yifanlu/psvsd/(threads)

Thread 1 (2017-05-31):

why dont you run the POR circuit from the 3.3V supply? :P

urjaman, 2017-05-31:
Save a resistor, and it'll actually do the reset off when the 3.3V goes up...

(Not a big issue, but github doesnt have that good messaging... feel free to close.)

yifanlu, 2017-05-31:
So the specs require that you hold reset low for 1us _after_ device powerup (which is 400us). Now if I have the LDO output directly to resetn, then there is no guarantee of the 1us hold. The RC circuit is there to ensure that this is the case. Quick calculation shows that since Vita's Vdd is a 4V output, we need a 165k/100k voltage divider to get ~2.5V output (which is a little above V_IH). The 0.1uF capacitor will make the ramp-up time ~30ms, which is good enough for the required 1us hold. Hope that makes sense.

urjaman, 2017-05-31:
I meant you could run R3 from VDD33 instead of VDD5 and remove R2.
This would give ... 10ms RC time with the current values, which again would be just fine.

yifanlu, 2017-05-31:
I see what you mean, but as long as it's not a problem, I don't think it's worth changing the circuit. The resistor is plenty cheap, so cost isn't an issue. And it's worth saving some current draw.

Closed 2017-05-31.

Thread 2 (2017-06-13):

Improve design with Microchip's feedback

yifanlu, 2017-06-13:
Microchip provided some good feedback on the design. However, in the interest of time and costs, I think the current design is "good enough" for the first run of cards. I think they will work 99.9% of the time in 99.9% of use cases. Incorporating these comments will only make it better.
[Lu Elec USB2244 USBCheck Review Results 6-13-2017.pdf](https://github.com/yifanlu/psvsd/files/1073111/Lu.Elec.USB2244.USBCheck.Review.Results.6-13-2017.pdf)
[Full Contact Via.pdf](https://github.com/yifanlu/psvsd/files/1073110/Full.Contact.Via.pdf)
[MLFApplicationNotes0908RevG[1].pdf](https://github.com/yifanlu/psvsd/files/1073113/MLFApplicationNotes0908RevG.1.pdf)
[USB 2.0 Routing Guidelines v1.0.pdf](https://github.com/yifanlu/psvsd/files/1073112/USB.2.0.Routing.Guidelines.v1.0.pdf)

The following will be done:

- [x] Select crystal with drive level between 300uW and 500uW with 350ppm accuracy
- [x] Recalculate C3 & C4, the crystal capacitors
- [x] Verify C7,C8 are low ESR
- [x] Improve POR circuit

yifanlu, 2017-06-22:
New crystal has 6pF load capacitance. This makes C3/C4 good enough.

Closed 2017-06-22.

Thread 3 (2017-09-10):

Ordering the Board on PCBWay

Gnarmagon, 2017-09-10:
I am new to ordering PCB's or even assembling them. I want to upgrade my PSVita with the Psvsd Board but sadly it's sold out on Indiegogo :(
I asked you already on Twitter where I can order the Board assembled and you told me to look on PCBWay but sadly I have no clue what to fill in or how to produce the Board. Can you give me a Screennshot of what you filled in ? / share the Project via Link if possible ? ([example](https://www.pcbway.com/project/shareproject/SD2VITA___Gadorach.html))

yifanlu, 2017-09-10:
1. Download both files from https://github.com/yifanlu/psvsd/releases/tag/v2.1.1
2. Go here https://www.pcbway.com/pcb-assembly.html "Quantity" (I recommend > 100 or it'll be REALLY expensive per unit) "Number of Unique Parts" = 11 "Number of SMT Parts" = 11 "Number of Thru-Holes Parts" = 0. Click calculate.
3. Now change "Assembly Side(s)" to Double sides. Click "PCB Specifications".
4. Change Quantity to the same quantity specified earlier. "Size (single)" = 30x33.2mm "Thickness" = 1.0 and leave other options as is.
5. Press calculate and add to cart. You will be asked to upload gerbers for the PCB (pass psvsd-v21-1.zip as is) and to upload the BOM (extract psvsd-v21-1-assembly.zip and pass in the xlsx).
6. Wait a day for them to send you the proper quote. Make sure to tell them to ensure that the GL823 part is the 3.3V version! This is important, they almost messed up the first time.

It will cost ~$1400 for 500 pieces. ~$700 for 100 pieces. ~$100 for 10 pieces and so on so it's cheaper to buy more at once.

Gnarmagon, 2017-09-11:
thanks for the Answer but for a normal Person it's way too expensive (the assemblie) :(

Closed 2017-09-11.

Thread 4 (2017-09-18):

Ordering small run.

DieKatzchen, 2017-09-18:
If I'm ordering boards for myself, do you think hasl is good enough or do I need to spring for the enig? Also, does the pad on u1 need to be connected or can I cheat by soldering around the edges? Or is it one of the qfn chips that don't have accessible edges?

yifanlu, 2017-09-18:
1) HASL is good enough
2) It's QFN (no edges)
3) Make sure you get the 3.3V version (the 5V version is called GL823B but is also labeled GL823 on the chip)

DieKatzchen, 2017-09-18:
Gotcha. Ended up buying it on aliexpress in the end, but this is all useful info to have. It should probably be mentioned somewhere that the board should be 1mm thick. Found that info on my own.

Closed 2017-09-18.

Thread 8 (2018-04-05):

psvemmc: resolve issues found by Microchip USBcheck

yifanlu, 2018-04-05:
[USB2244 USBCheck Review Results 4-5-2018.pdf](https://github.com/yifanlu/psvsd/files/1880809/USB2244.USBCheck.Review.Results.4-5-2018.pdf)
[Schematic Checklist USB2244 QFN Rev A.pdf](https://github.com/yifanlu/psvsd/files/1880810/Schematic.Checklist.USB2244.QFN.Rev.A.pdf)

Thread 9 (2018-08-16):

PSVSD 2.1 discharging the battery in TURN OFF mode

sin89rus, 2018-08-16:
first i have psvsd (copy from ALI) v 2.1
i grounded shield like in v 2.1.1
when Vita is turned OFF (not sleeping) mode, its slowly discharging the battery - 1% in 2hrs
if i etract PSVSD module, The battery is not discharged even by one percent for the whole day

nobody have this problem?
i think copy made by official manual, and If this problem is present here, then it is in the original

yifanlu, 2018-08-16:
1% in 2 hours is not typical but also not unusual. It’s worse if your battery is old and has a lower capacity.

sin89rus, 2018-08-16:
New tests result:
 separate from each other - PSVSD and Vita Memory Card working fine without battery discharge
 But when together it's happened - minus 10% for a night.
Are you know the solution? You can test it by your self.

yifanlu, 2018-08-16:
I've tested it before
https://drive.google.com/open?id=0B8s1lpCIQGWCTnJzMjA1aGhndTQ

sin89rus, 2018-08-17:
please hear me: discharge happened ONLY if PSVSD and Vita Original MC inserted together.
If only PSVSD - discharge not happened
If only Vita MC - discharge not happened
If Both - battery start draining

Just put both inside, remember the battery % (battery shell will be useful), power off, check in 4 hours how much % battery loose.
Maybe it's happened only in Chinese copy of PSVSD, I can't check it with original one, but you can.
Maybe it's some resistance between PSVSD and Vita MC which draining battery

yifanlu, 2018-08-17:
That is weird, but there is no correlation between the two. I do not personally have any Vitas to test with but if anyone else can reproduce, I would be curious.

sin89rus, 2018-08-17:
Seems like problem gone.
I just replug battery connector (I don't unplug it before).
Looks like you need unplug battery, then insert PSVSD and plug battery connector back.

sin89rus, 2018-08-17:
Seems like problem gone.
I just replug battery connector (I don't unplug it before).
Looks like you need unplug battery, then insert PSVSD and plug battery connector back.

Closed 2018-08-16.

Thread 11 (2019-05-26):

PSVSD drains bettery even if turned off

K4thos, 2019-05-26:
My PSVSD v2.1 (official one sold by you, not the third party) discharges Vita battery even if the system is completely turned off (power button held for a few seconds and selecting turn off option). It's not much, since it takes several days to drain 10% of the battery (the percantage can be checked after installing plugin or via Adrenaline), but if you leave your system long enough, it will discharge the device to the point to not be able to even turn it on again. Apparently leaving a lithium ion battery completely dry for a month is the worst thing you can do for battery health and this will be the case if you stop using your system and leave PSVSD inside.

I've noticed similar issue reported before: https://github.com/yifanlu/psvsd/issues/9 but I didn't managed to fix it. I've tried following things to make sure that it's PSVSD v2.1 that is causing the discharge:
- leaving PS Vita turned off for about a week without PSVSD - no battery discharge whatsoever (exactly the same % of the battery)
- leaving PS Vita turned off for about week with PSVSD - several % drained,
- as above but after removing and inserting back the battery - same problem with discharge
- as above but also after removing official memory card (as was suggested in the linked issue) - same problem with discharge
- after removing PSVSD again, I’ve inserted 3G module back and the problem is no longer present (no battery discharge)

So now, after several weeks of testing, I’m reporting it here hoping for a software solution. Hopefully it’s not a unfixable PSVSD hardware flaw.

mathieulh, 2019-12-20:
I am also using the official psvsd and I have the same issue, battery drains even while the Vita is off.

dudeitssm, 2020-01-08:
I wonder...would it be possible to use a high-side load switch? That should cut down current consumption of whatever is connected on the output side to no more than a few microAmps, or even [nanoAmps](https://www.vishay.com/docs/66597/sip32431.pdf) when the PSV is off (or the EN pin does not get a HIGH signal) and thus extend the battery life to approximately whatever the self-discharge rate is for the lipo battery.

This is what I'm thinking as the flowchart:
**0**. Turn PSV on from off state.
**1**. Obtain a signal from the PSV's motherboard that is _only_ present when the PSV is on, but is _not_ on during suspend mode.
**2**. That signal is fed into the EN pin of the load switch, which activates the psvsd components. The PSV boots up and psvsd mounts sdcard as usual.
**3**. Turn PSV off, or suspend it.
**4**. The signal that was active high when PSV was on goes away, and the EN pin sees 0V, turning off the output side and psvsd components.

No idea if this idea would play nicely with the current psvsd software driver. Unfortunately, I am not a programmer. Maybe I should get a PSV1000 3G model and try it out myself? I have a 2001 model only, at the moment.

Thoughts?

Thread 13 (2020-08-07):

Supplier GL823A

bitShakeMX, 2020-08-07:
Hi, I'm looking for a supplier of the GL823, could you help me?

Regards,

legoboy0109, 2020-10-05:
I'm in the process of building some of these myself, and for some reason JLCPCB has the SSOP version, but not the QFN24 version of the chip, so I ordered some from UTSOURCE. I believe they were around .50$ a chip. JLC has everything else except the LED, but you can easily swap it for something else.

bitShakeMX, 2020-10-09:
Hi @legoboy0109, I couldn't buy it, so I had to find an other sd reader IC. I found a part used in laptops AU6465 from Alcor, cheap and very reliable.

legoboy0109, 2020-10-22:
Was it easy enough to change the chip in the schematic? I can't imagine it was too hard.

espetoet, 2020-11-13:
Hello someone has to sell psvsd

tpimh, 2020-12-29:
Hi @bitShakeMX, I couldn't find any datasheet for AU6465. Could you share yours?

Bakuku, 2023-05-17:
> Hello someone has to sell psvsd

I'm on it ;)
