yifanlu/psvsd/psvemmc/psvemmc-v30.brd

## EAGLE design psvemmc/psvemmc-v30.brd (2018-08-12)

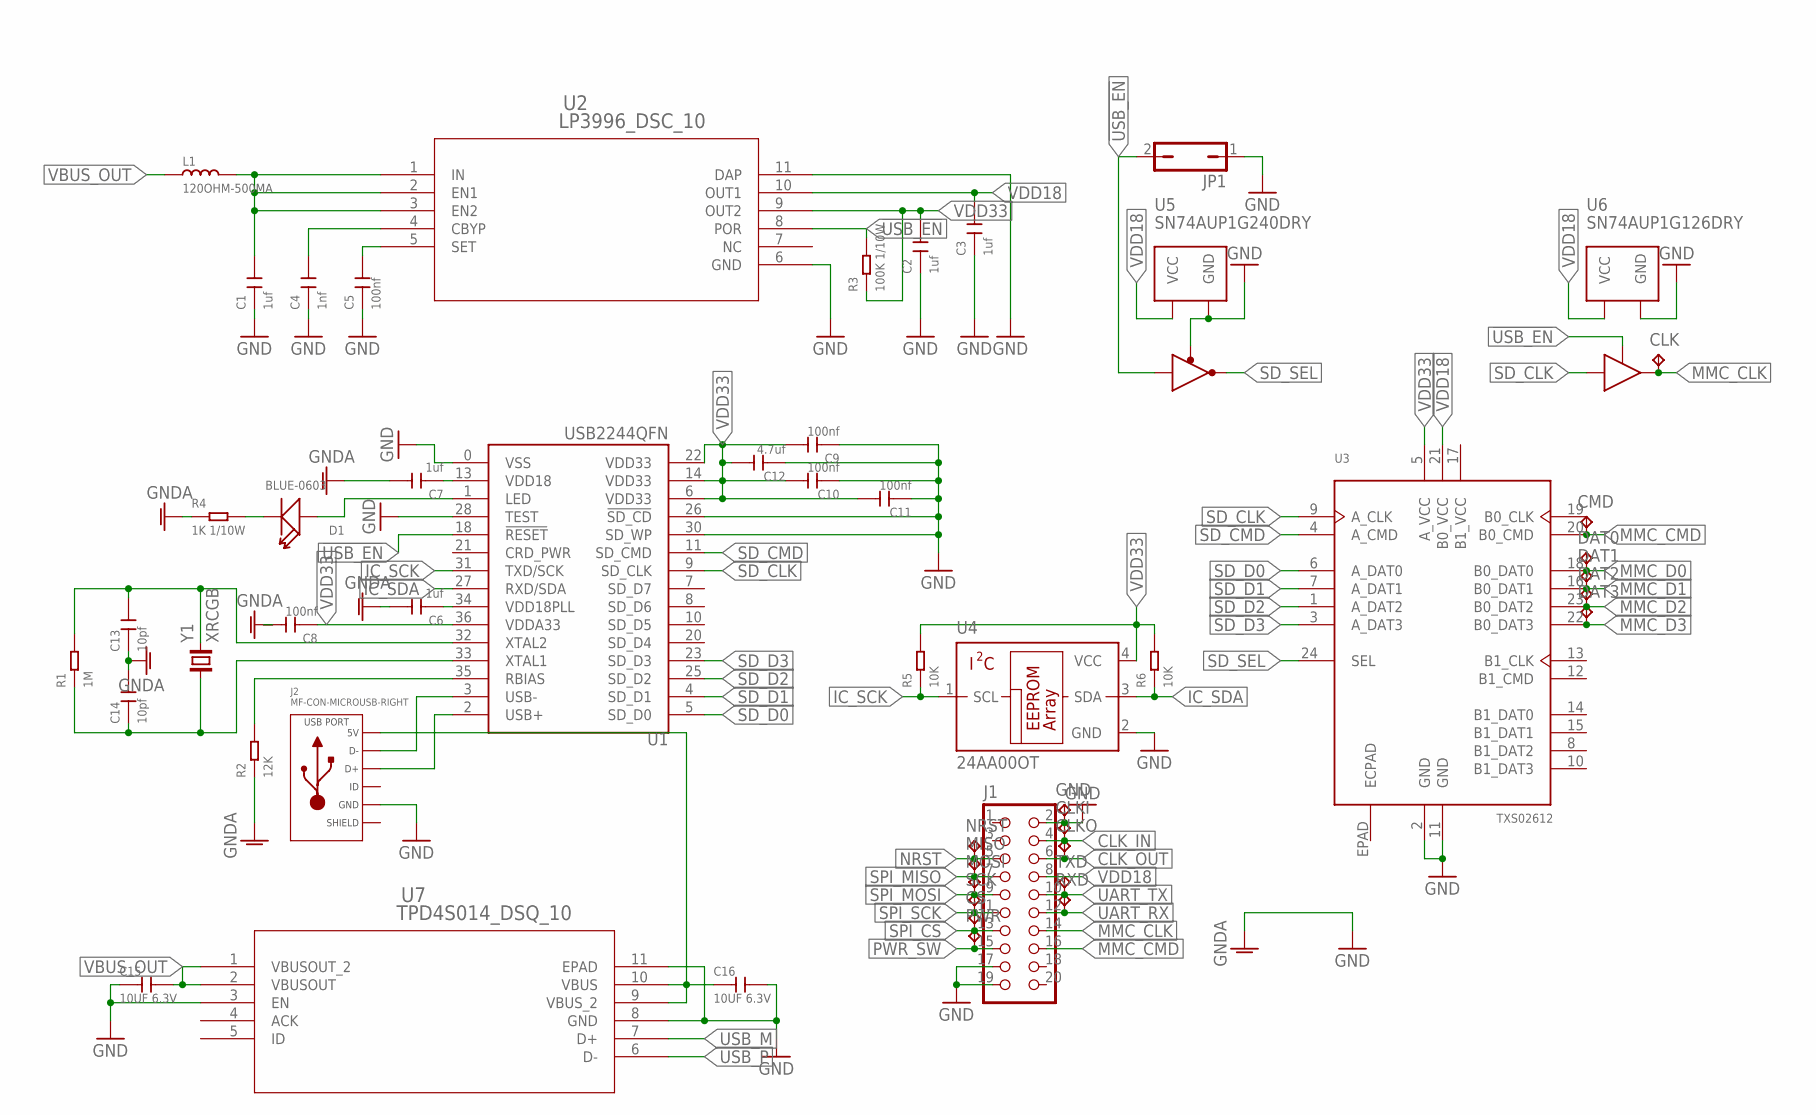
[picture p1: schematic psvemmc-v30.sch]

Parts:
C1, C2, C3, C6, C7: 1uf; C0603
C4: 1nf; C0603
C5, C8, C9, C10, C11: 100nf; C0603
C12: 4.7uf; C0603
C13, C14: 10pf; C0603
C15, C16: 10UF 6.3V; C0603
CLK: TPTP10R; TP10R
CLKI: TPTP10R; TP10R
CLKO: TPTP10R; TP10R
CMD: TPTP10R; TP10R
CS: TPTP10R; TP10R
D1: BLUE-0603; LED-0603
DAT0, DAT1, DAT2, DAT3: TPTP10R; TP10R
GND: TPTP10R; TP10R
J1: CON_HEADER_2X10-SHROUDED; PINSHRD_PTH_2X10
J2: MF-CON-MICROUSB-RIGHT; MICROUSB-RIGHT
JP1: JP1Q; JP1
L1: 120OHM-500MA; L0603
MISO: TPTP10R; TP10R
MOSI: TPTP10R; TP10R
NRST: TPTP10R; TP10R
PWR: TPTP10R; TP10R
R1: 1M; R0603
R2: 12K; R0603
R3: 100K 1/10W; R0603
R4: 1K 1/10W; R0603
R5, R6: 10K; R0603
RXD: TPTP10R; TP10R
SCK: TPTP10R; TP10R
TXD: TPTP10R; TP10R
U1: USB2244QFN; QFN36
U2: LP3996_DSC_10; SDA10A
U3: TXS02612; S-PWQFN-N24
U4: 24AA00OT; SOT23-5L
U5: SN74AUP1G240DRY; DRY6
U6: SN74AUP1G126DRY; DRY6
U7: TPD4S014_DSQ_10; DSQ10_1P5X0P9
Y1: XRCGB

Connections:
!USB_EN: JP1.2, R3.2, U1.18 (!RESET), U2.8 (POR), U5.2 (A), U6.1 (OE)
B1_VCC: U3.17 (B1_VCC)
CLK_IN: CLKI.TP, J1.4
CLK_OUT: CLKO.TP, J1.6
ECPAD: U3.EPAD (ECPAD)
GND: C1.1, C2.1, C3.1, C4.1, C5.1, C6.2, C7.2, C8.2, C9.1, C10.1, C11.1, C12.1, C13.1, C14.2, C15.1, C16.2, GND.TP, J1.2, J1.17, J1.19, J2.5 (GND), JP1.1, R2.1, R4.1, U1.0 (VSS), U1.26 (!SD_CD), U1.28 (TEST), U1.30 (SD_WP), U2.6 (GND), U2.11 (DAP), U3.2 (GND), U3.11 (GND), U4.2 (GND), U5.1 (!OE), U5.3 (GND), U6.3 (GND), U7.3 (EN), U7.8 (GND), U7.11 (EPAD)
IC_SCK: R5.1, U1.31 (TXD/SCK), U4.1 (SCL)
IC_SDA: R6.1, U1.27 (RXD/SDA), U4.3 (SDA)
LED: D1.+, U1.1 (LED)
LED_M: D1.-, R4.2
MMC_CLK: CLK.TP, J1.14, U6.4 (Y)
MMC_CMD: CMD.TP, J1.16, U3.20 (B0_CMD)
MMC_D0: DAT0.TP, U3.18 (B0_DAT0)
MMC_D1: DAT1.TP, U3.16 (B0_DAT1)
MMC_D2: DAT2.TP, U3.23 (B0_DAT2)
MMC_D3: DAT3.TP, U3.22 (B0_DAT3)
unnamed: C4.2, U2.4 (CBYP)
NRST: J1.5, NRST.TP
PWR_SW: J1.15, PWR.TP
RBIAS: R2.2, U1.35 (RBIAS)
SD_CLK: U1.9 (SD_CLK), U3.9 (A_CLK), U6.2 (A)
SD_CMD: U1.11 (SD_CMD), U3.4 (A_CMD)
SD_D0: U1.5 (SD_D0), U3.6 (A_DAT0)
SD_D1: U1.4 (SD_D1), U3.7 (A_DAT1)
SD_D2: U1.25 (SD_D2), U3.1 (A_DAT2)
SD_D3: U1.23 (SD_D3), U3.3 (A_DAT3)
SD_SEL: U3.24 (SEL), U5.4 (Y)
SET: C5.2, U2.5 (SET)
SLD: J2.S1 (SLD), J2.S2 (SLD), J2.S3 (SLD), J2.S4 (SLD), J2.S5 (SLD), J2.S6 (SLD)
SPI_CS: CS.TP, J1.13
SPI_MISO: J1.7, MISO.TP
SPI_MOSI: J1.9, MOSI.TP
SPI_SCK: J1.11, SCK.TP
UART_RX: J1.12, RXD.TP
UART_TX: J1.10, TXD.TP
USB_5V: C16.1, J2.1 (5V), U7.9 (VBUS_2), U7.10 (VBUS)
USB_M: J2.2 (D-), U1.3 (USB-), U7.7 (D+)
USB_P: J2.3 (D+), U1.2 (USB+), U7.6 (D-)
VBUS_OUT: C15.2, L1.1, U7.1 (VBUSOUT_2), U7.2 (VBUSOUT)
VDD5: C1.2, L1.2, U2.1 (IN), U2.2 (EN1), U2.3 (EN2)
VDD18: C3.2, J1.8, U2.10 (OUT1), U3.21 (B0_VCC), U5.6 (VCC), U6.6 (VCC)
VDD18_PLL: C6.1, U1.34 (VDD18PLL)
VDD18_USB: C7.1, U1.13 (VDD18)
VDD33: C2.2, C8.1, C9.2, C10.2, C11.2, C12.2, R3.1, R5.2, R6.2, U1.6 (VDD33), U1.14 (VDD33), U1.22 (VDD33), U1.36 (VDDA33), U2.9 (OUT2), U3.5 (A_VCC), U4.4 (VCC)
XTAL1: C14.1, R1.1, U1.33 (XTAL1), Y1.1
XTAL2: C13.2, R1.2, U1.32 (XTAL2), Y1.3 (2)

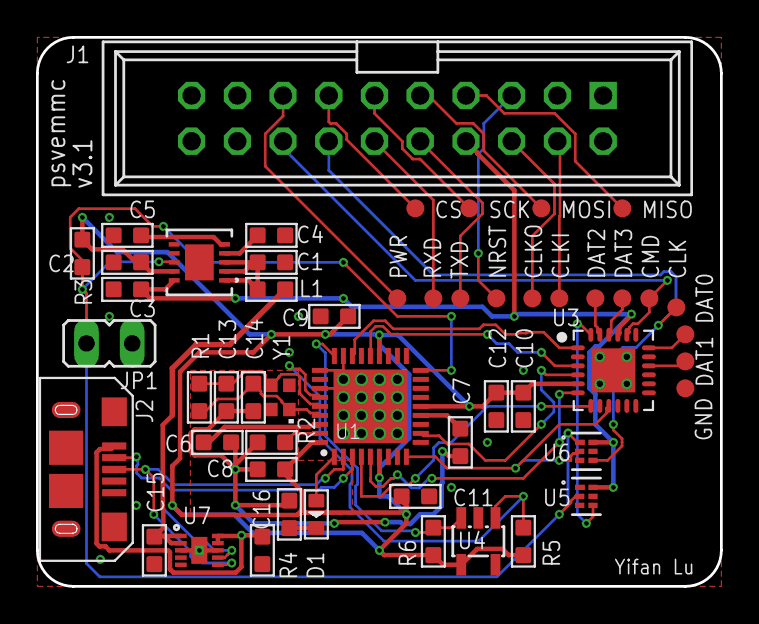
[picture p2: board psvemmc-v30.brd from above]

Board: 2 copper layers, 38.0 x 30.5 mm, 52 parts (0 on the bottom side), 44 nets.
