yifanlu/psvsd/psvemmc/psvemmc-v10.brd

## EAGLE design psvemmc/psvemmc-v10.brd (2018-03-15, an earlier design)

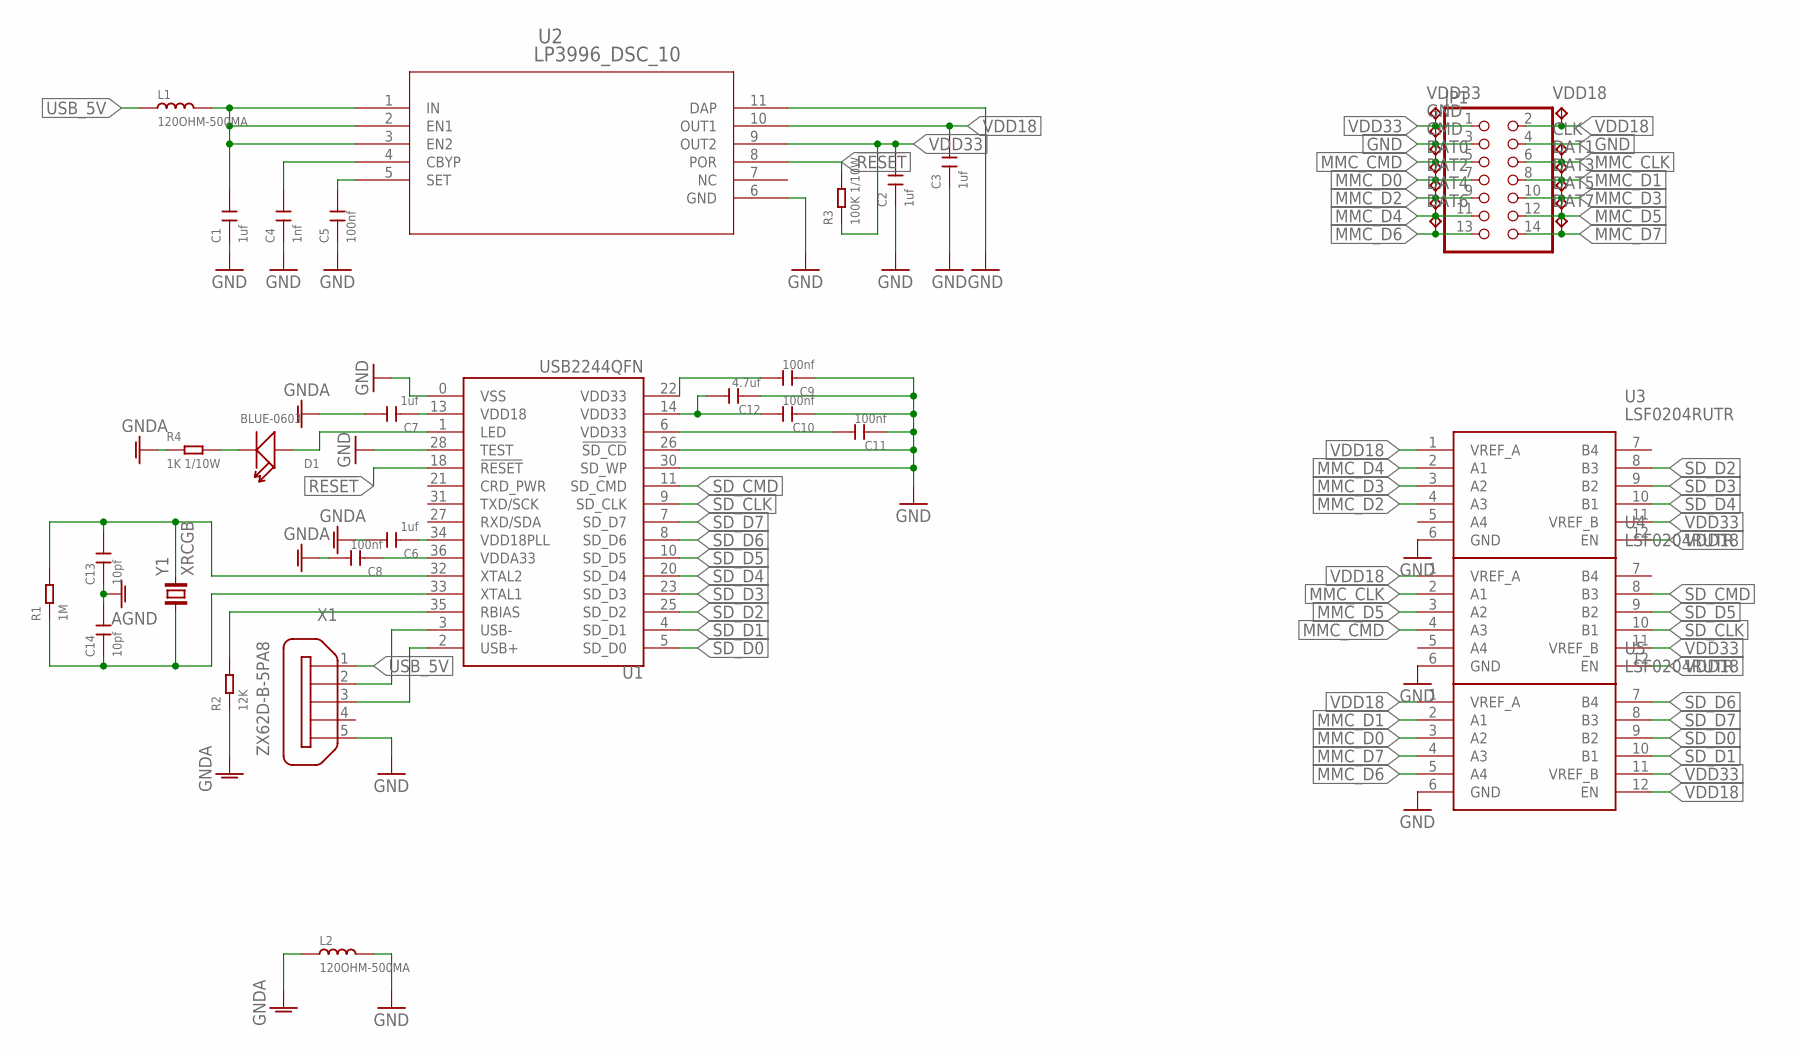
[picture p3: schematic psvemmc-v10.sch]

Parts:
C1, C2, C3, C6, C7: 1uf; C0603
C4: 1nf; C0603
C5, C8, C9, C10, C11: 100nf; C0603
C12: 4.7uf; C0603
C13, C14: 10pf; C0603
CLK: TPTP20SQ; TP20SQ
CMD: TPTP20SQ; TP20SQ
D1: BLUE-0603; LED-0603
DAT0, DAT1, DAT2, DAT3, DAT4, DAT5, DAT6, DAT7: TPTP20SQ; TP20SQ
GND: TPTP20SQ; TP20SQ
JP1: PINHD-2X7; 2X07
L1, L2: 120OHM-500MA; L0603
R1: 1M; R0603
R2: 12K; R0603
R3: 100K 1/10W; R0603
R4: 1K 1/10W; R0603
U1: USB2244QFN; QFN36
U2: LP3996_DSC_10; SDA10A
U3, U4, U5: LSF0204RUTR; RUT(R-PUQFN-N12)
VDD18, VDD33: TPTP20SQ; TP20SQ
X1: ZX62D-B-5PA8
Y1: XRCGB

Connections:
!RESET: R3.2, U1.18 (!RESET), U2.8 (POR)
GND: C1.1, C2.1, C3.1, C4.1, C5.1, C9.1, C10.1, C11.1, C12.1, GND.TP, JP1.3, JP1.4, L2.2, U1.0 (VSS), U1.26 (!SD_CD), U1.28 (TEST), U1.30 (SD_WP), U2.6 (GND), U2.11 (DAP), U3.6 (GND), U4.6 (GND), U5.6 (GND), X1.5
GNDA: C6.2, C7.2, C8.2, C13.1, C14.2, L2.1, R2.1, R4.1
LED: D1.+, U1.1 (LED)
LED_M: D1.-, R4.2
MMC_CLK: CLK.TP, JP1.6, U4.2 (A1)
MMC_CMD: CMD.TP, JP1.5, U4.4 (A3)
MMC_D0: DAT0.TP, JP1.7, U5.3 (A2)
MMC_D1: DAT1.TP, JP1.8, U5.2 (A1)
MMC_D2: DAT2.TP, JP1.9, U3.4 (A3)
MMC_D3: DAT3.TP, JP1.10, U3.3 (A2)
MMC_D4: DAT4.TP, JP1.11, U3.2 (A1)
MMC_D5: DAT5.TP, JP1.12, U4.3 (A2)
MMC_D6: DAT6.TP, JP1.13, U5.5 (A4)
MMC_D7: DAT7.TP, JP1.14, U5.4 (A3)
unnamed: C4.2, U2.4 (CBYP)
RBIAS: R2.2, U1.35 (RBIAS)
SD_CLK: U1.9 (SD_CLK), U4.10 (B1)
SD_CMD: U1.11 (SD_CMD), U4.8 (B3)
SD_D0: U1.5 (SD_D0), U5.9 (B2)
SD_D1: U1.4 (SD_D1), U5.10 (B1)
SD_D2: U1.25 (SD_D2), U3.8 (B3)
SD_D3: U1.23 (SD_D3), U3.9 (B2)
SD_D4: U1.20 (SD_D4), U3.10 (B1)
SD_D5: U1.10 (SD_D5), U4.9 (B2)
SD_D6: U1.8 (SD_D6), U5.7 (B4)
SD_D7: U1.7 (SD_D7), U5.8 (B3)
SET: C5.2, U2.5 (SET)
USB_5V: L1.1, X1.1
USB_M: U1.3 (USB-), X1.2
USB_P: U1.2 (USB+), X1.3
VDD5: C1.2, L1.2, U2.1 (IN), U2.2 (EN1), U2.3 (EN2)
VDD18: C3.2, JP1.2, U2.10 (OUT1), U3.1 (VREF_A), U3.12 (EN), U4.1 (VREF_A), U4.12 (EN), U5.1 (VREF_A), U5.12 (EN), VDD18.TP
VDD18_PLL: C6.1, U1.34 (VDD18PLL)
VDD18_USB: C7.1, U1.13 (VDD18)
VDD33: C2.2, C8.1, C9.2, C10.2, C11.2, C12.2, JP1.1, R3.1, U1.6 (VDD33), U1.14 (VDD33), U1.22 (VDD33), U1.36 (VDDA33), U2.9 (OUT2), U3.11 (VREF_B), U4.11 (VREF_B), U5.11 (VREF_B), VDD33.TP
XTAL1: C14.1, R1.1, U1.33 (XTAL1), Y1.1
XTAL2: C13.2, R1.2, U1.32 (XTAL2), Y1.3 (2)

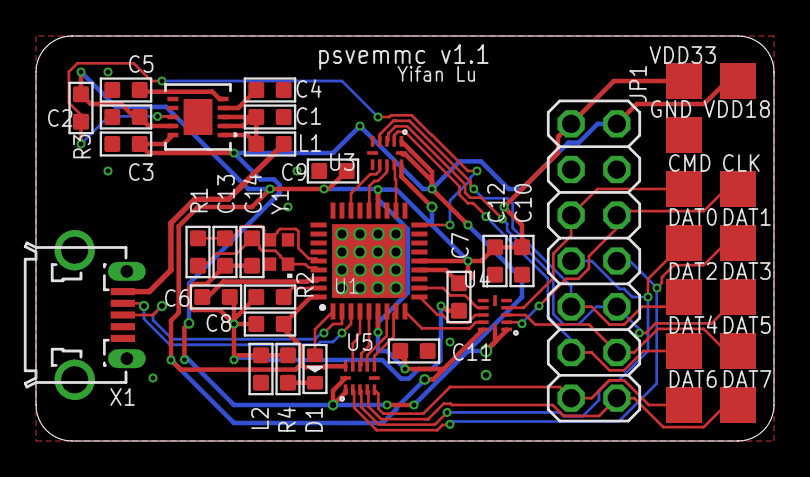
[picture p4: board psvemmc-v10.brd from above]

Board: 2 copper layers, 41.0 x 22.5 mm, 42 parts (0 on the bottom side), 38 nets.
