yifanlu/psvsd/psvsd/psvsd-v21.brd

## EAGLE design psvsd/psvsd-v21.brd (2017-08-17)

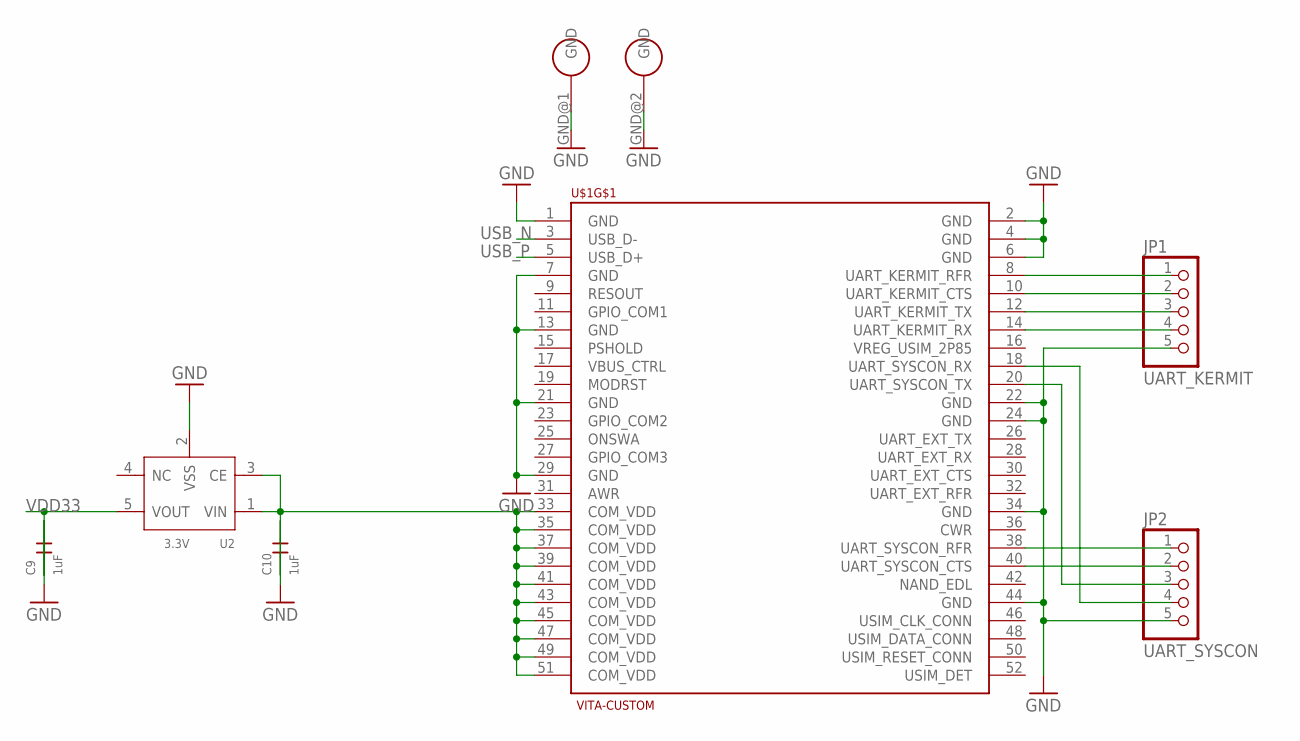
[picture p5: schematic psvsd-v21.sch, sheet 1, Connections]

Parts:
C9, C10: 1uF; C0603
JP1: UART_KERMIT; 1X05
JP2: UART_SYSCON; 1X05
U2: 3.3V; SOT-23-5
U$1: VITA-CUSTOM; VITA-MINI-PCI-E

Connections:
GND: C9.2, C10.2, JP1.5, JP2.5, U2.2 (VSS), U$1.1 (GND), U$1.2 (GND), U$1.4 (GND), U$1.6 (GND), U$1.7 (GND), U$1.13 (GND), U$1.21 (GND), U$1.22 (GND), U$1.24 (GND), U$1.29 (GND), U$1.34 (GND), U$1.44 (GND), U$1.GND@1 (GND), U$1.GND@2 (GND); also elsewhere on the board
UART_KERMIT_CTS: JP1.2, U$1.10 (UART_KERMIT_CTS)
UART_KERMIT_RFR: JP1.1, U$1.8 (UART_KERMIT_RFR)
UART_KERMIT_RX: JP1.4, U$1.14 (UART_KERMIT_RX)
UART_KERMIT_TX: JP1.3, U$1.12 (UART_KERMIT_TX)
UART_SYSCON_CTS: JP2.2, U$1.40 (UART_SYSCON_CTS)
UART_SYSCON_RFR: JP2.1, U$1.38 (UART_SYSCON_RFR)
UART_SYSCON_RX: JP2.4, U$1.18 (UART_SYSCON_RX)
UART_SYSCON_TX: JP2.3, U$1.20 (UART_SYSCON_TX)
USB_N: U$1.3 (USB_D-); also elsewhere on the board
USB_P: U$1.5 (USB_D+); also elsewhere on the board
VDD: C10.1, U2.1 (VIN), U2.3 (CE), U$1.33 (COM_VDD), U$1.35 (COM_VDD), U$1.37 (COM_VDD), U$1.39 (COM_VDD), U$1.41 (COM_VDD), U$1.43 (COM_VDD), U$1.45 (COM_VDD), U$1.47 (COM_VDD), U$1.49 (COM_VDD), U$1.51 (COM_VDD)
VDD33: C9.1, U2.5 (VOUT); also elsewhere on the board

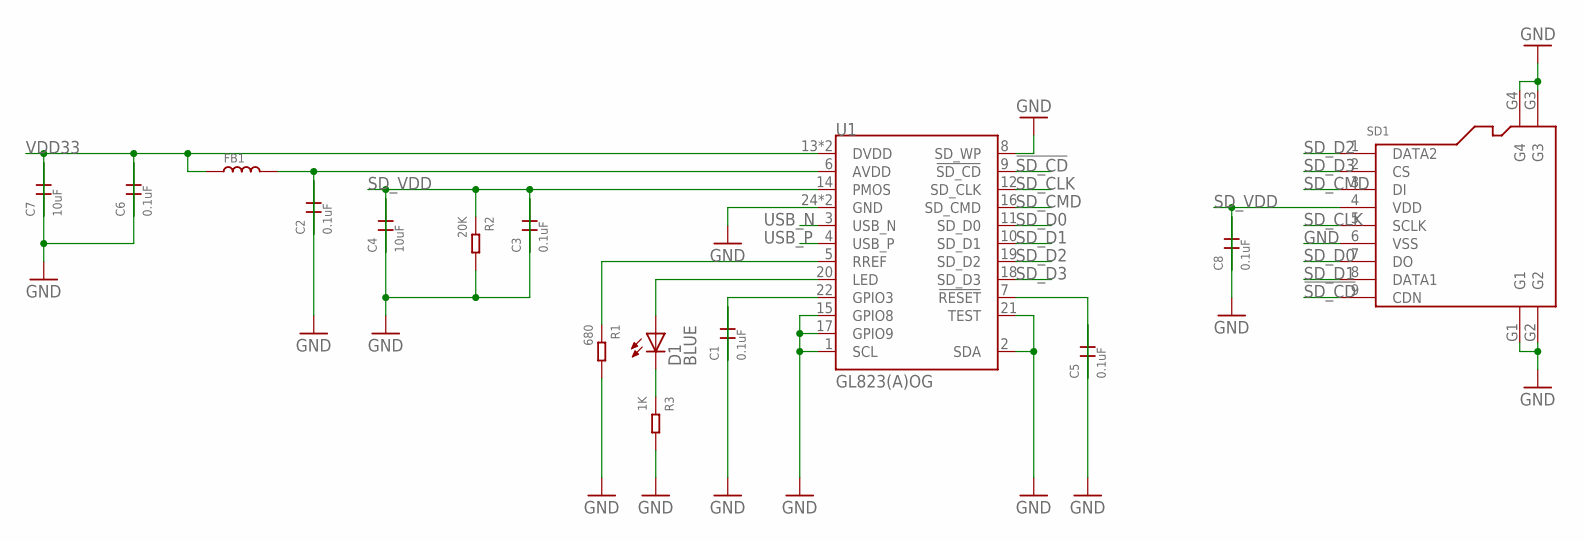
[picture p6: schematic psvsd-v21.sch, sheet 2, USB to SD]

Parts:
C1, C2, C3, C5, C6, C8: 0.1uF; C0603
C4, C7: 10uF; C0603
D1: BLUE; CHIP-LED0603
FB1: SMD-FERRITE-BEAD-2500R-50MA(0603); L0603
R1: 680; R0603
R2: 20K; R0603
R3: 1K; R0603
SD1: MICRO-SD-CARD-SOCKET-9P(ST-TF-003A); MICRO-SD9+4P-SMD-16.1X14.5X1.85MM
U1: GL823(A)OG; QFN-24

Connections:
!RESET: C5.1, U1.7 (!RESET)
!SD_CD: SD1.9 (CDN), U1.9 (!SD_CD)
AVDD33: C2.1, FB1.2, U1.6 (AVDD)
GND: C1.2, C2.2, C3.2, C4.2, C5.2, C6.2, C7.2, C8.2, R1.2, R2.2, R3.2, SD1.6 (VSS), SD1.G1, SD1.G2, SD1.G3, SD1.G4, U1.1 (SCL), U1.2 (SDA), U1.8 (SD_WP), U1.15 (GPIO8), U1.17 (GPIO9), U1.21 (TEST), U1.24 (GND), U1.25 (GND); also elsewhere on the board
GPIO3: C1.1, U1.22 (GPIO3)
LED: D1.A, U1.20 (LED)
LED_N: D1.C, R3.1
RREF: R1.1, U1.5 (RREF)
SD_CLK: SD1.5 (SCLK), U1.12 (SD_CLK)
SD_CMD: SD1.3 (DI), U1.16 (SD_CMD)
SD_D0: SD1.7 (DO), U1.11 (SD_D0)
SD_D1: SD1.8 (DATA1), U1.10 (SD_D1)
SD_D2: SD1.1 (DATA2), U1.19 (SD_D2)
SD_D3: SD1.2 (CS), U1.18 (SD_D3)
SD_VDD: C3.1, C4.1, C8.1, R2.1, SD1.4 (VDD), U1.14 (PMOS)
USB_N: U1.3 (USB_N); also elsewhere on the board
USB_P: U1.4 (USB_P); also elsewhere on the board
VDD33: C6.1, C7.1, FB1.1, U1.13 (DVDD), U1.23 (DVDD); also elsewhere on the board

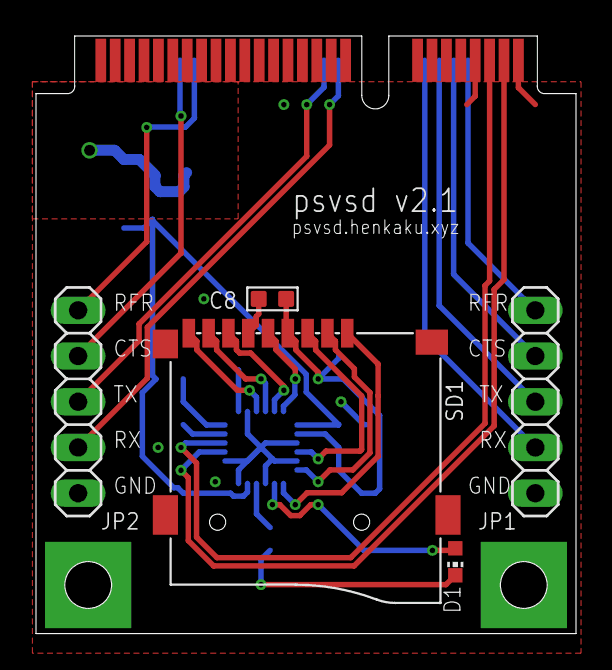
[picture p7: board psvsd-v21.brd from above]

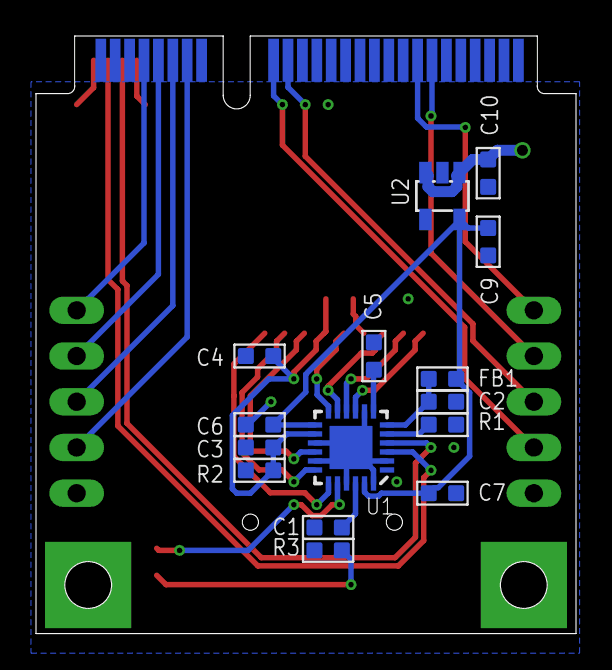
[picture p8: board psvsd-v21.brd from below]

Board: 2 copper layers, 30.0 x 33.2 mm, 21 parts (15 on the bottom side), 27 nets.
