yifanlu/psvsd/psvsd/psvsd-v10.brd

## EAGLE design psvsd/psvsd-v10.brd (2017-06-22, an earlier design)

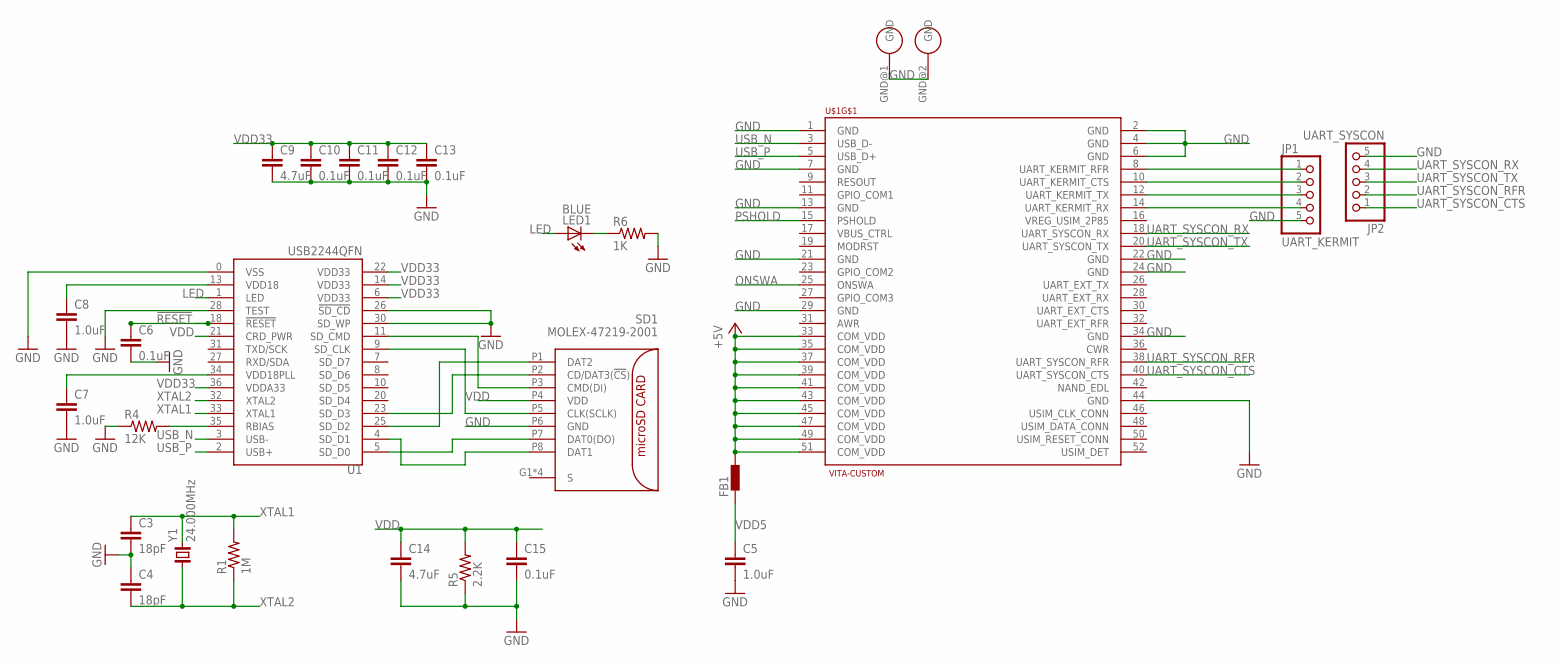
[picture p9: schematic psvsd-v10.sch, sheet 1, SD/USB]

Parts:
C3, C4: 18pF; C0402
C5, C7, C8: 1.0uF; C0603
C6, C10, C11, C12, C13, C15: 0.1uF; C0402
C9, C14: 4.7uF; C0603
FB1: BLM15HB121SN1; 0402
JP1: UART_KERMIT; 1X05
JP2: UART_SYSCON; 1X05
LED1: BLUE; SML0603
R1: 1M; R0603
R4: 12K; R0603
R5: 2.2K; R0603
R6: 1K; R0603
SD1: MOLEX-47219-2001; MOLEX:47219-2001
U1: USB2244QFN; QFN36
U$1: VITA-CUSTOM; VITA-MINI-PCI-E
Y1: 24.000MHz; XRCGB

Connections:
!RESET: C6.1, U1.18 (!RESET); also elsewhere on the board
+5V: FB1.2, U$1.33 (COM_VDD), U$1.35 (COM_VDD), U$1.37 (COM_VDD), U$1.39 (COM_VDD), U$1.41 (COM_VDD), U$1.43 (COM_VDD), U$1.45 (COM_VDD), U$1.47 (COM_VDD), U$1.49 (COM_VDD), U$1.51 (COM_VDD)
GND: C3.2, C4.1, C5.2, C6.2, C7.2, C8.2, C9.2, C10.2, C11.2, C12.2, C13.2, C14.2, C15.2, JP1.5, JP2.5, R4.1, R5.1, R6.2, SD1.P6 (GND), U1.0 (VSS), U1.26 (!SD_CD), U1.28 (TEST), U1.30 (SD_WP), U$1.1 (GND), U$1.2 (GND), U$1.4 (GND), U$1.6 (GND), U$1.7 (GND), U$1.13 (GND), U$1.21 (GND), U$1.22 (GND), U$1.24 (GND), U$1.29 (GND), U$1.34 (GND), U$1.44 (GND), U$1.GND@1 (GND), U$1.GND@2 (GND); also elsewhere on the board
LED: LED1.A, U1.1 (LED)
unnamed: LED1.C, R6.1
ONSWA: U$1.25 (ONSWA); also elsewhere on the board
PSHOLD: U$1.15 (PSHOLD); also elsewhere on the board
RBIAS: R4.2, U1.35 (RBIAS)
SD_CLK: SD1.P5 (CLK(SCLK)), U1.9 (SD_CLK)
SD_CMD: SD1.P3 (CMD(DI)), U1.11 (SD_CMD)
SD_D0: SD1.P7 (DAT0(DO)), U1.5 (SD_D0)
SD_D1: SD1.P8 (DAT1), U1.4 (SD_D1)
SD_D2: SD1.P1 (DAT2), U1.25 (SD_D2)
SD_D3: SD1.P2 (CD/DAT3(!CS!)), U1.23 (SD_D3)
UART_KERMIT_CTS: JP1.2, U$1.10 (UART_KERMIT_CTS)
UART_KERMIT_RFR: JP1.1, U$1.8 (UART_KERMIT_RFR)
UART_KERMIT_RX: JP1.4, U$1.14 (UART_KERMIT_RX)
UART_KERMIT_TX: JP1.3, U$1.12 (UART_KERMIT_TX)
UART_SYSCON_CTS: JP2.1, U$1.40 (UART_SYSCON_CTS)
UART_SYSCON_RFR: JP2.2, U$1.38 (UART_SYSCON_RFR)
UART_SYSCON_RX: JP2.4, U$1.18 (UART_SYSCON_RX)
UART_SYSCON_TX: JP2.3, U$1.20 (UART_SYSCON_TX)
USBVDD18: C8.1, U1.13 (VDD18)
USBVDD18PLL: C7.1, U1.34 (VDD18PLL)
USB_N: U1.3 (USB-), U$1.3 (USB_D-)
USB_P: U1.2 (USB+), U$1.5 (USB_D+)
VDD: C14.1, C15.1, R5.2, SD1.P4 (VDD), U1.21 (CRD_PWR)
VDD5: C5.1, FB1.1; also elsewhere on the board
VDD33: C9.1, C10.1, C11.1, C12.1, C13.1, U1.6 (VDD33), U1.14 (VDD33), U1.22 (VDD33), U1.36 (VDDA33); also elsewhere on the board
XTAL1: C3.1, R1.2, U1.33 (XTAL1), Y1.3 (2)
XTAL2: C4.2, R1.1, U1.32 (XTAL2), Y1.1

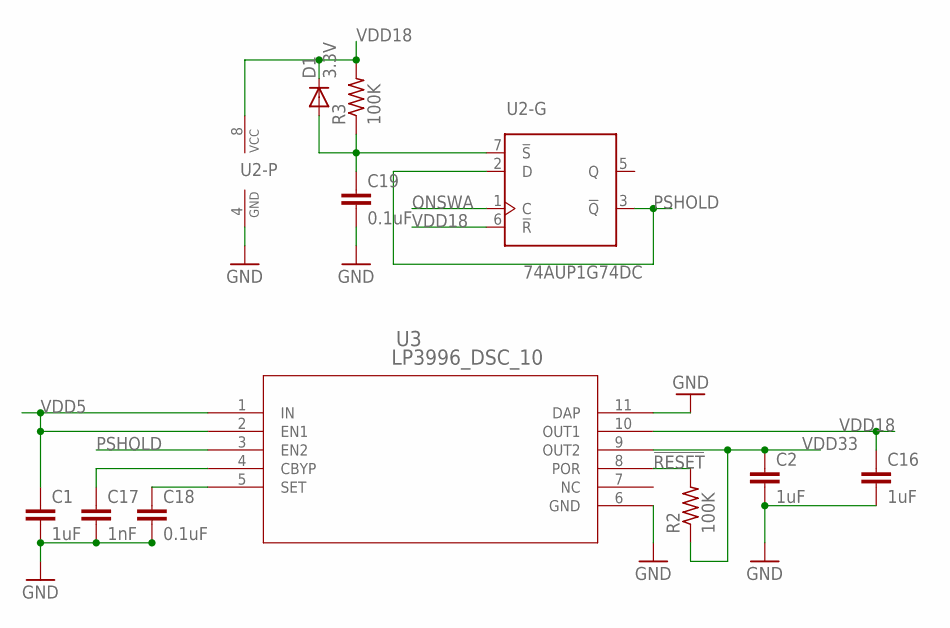
[picture p10: schematic psvsd-v10.sch, sheet 2, Power Management]

Parts:
C1, C2, C16: 1uF; C0603
C17: 1nF; C0402
C18, C19: 0.1uF; C0402
D1: 3.3V; SOD523
R2, R3: 100K; R0603
U2: 74AUP1G74DC; SOT765
U3: LP3996_DSC_10; SDA10A

Connections:
!RESET: R2.2, U3.8 (POR); also elsewhere on the board
!S: C19.1, D1.A, R3.1, U2.7 (!S)
CBYP: C17.1, U3.4 (CBYP)
CSET: C18.1, U3.5 (SET)
GND: C1.2, C2.2, C16.2, C17.2, C18.2, C19.2, U2.4 (GND), U3.6 (GND), U3.11 (DAP); also elsewhere on the board
ONSWA: U2.1 (C); also elsewhere on the board
PSHOLD: U2.2 (D), U2.3 (!Q), U3.3 (EN2); also elsewhere on the board
VDD5: C1.1, U3.1 (IN), U3.2 (EN1); also elsewhere on the board
VDD18: C16.1, D1.C, R3.2, U2.6 (!R), U2.8 (VCC), U3.10 (OUT1)
VDD33: C2.1, R2.1, U3.9 (OUT2); also elsewhere on the board

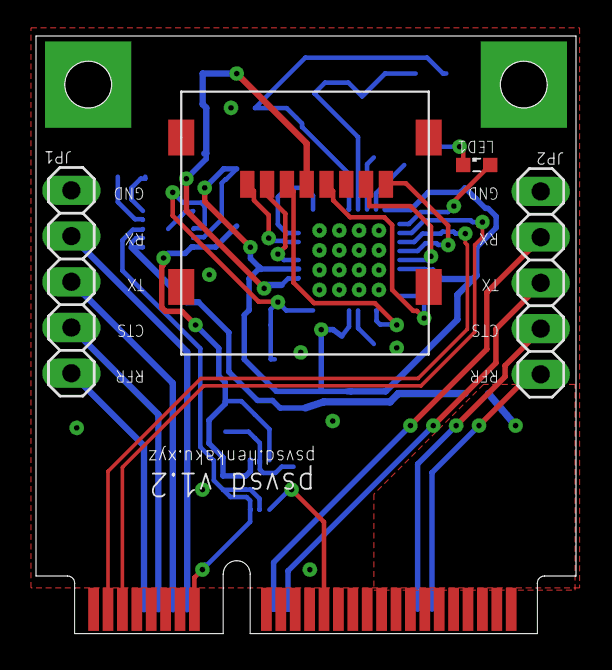
[picture p11: board psvsd-v10.brd from above]

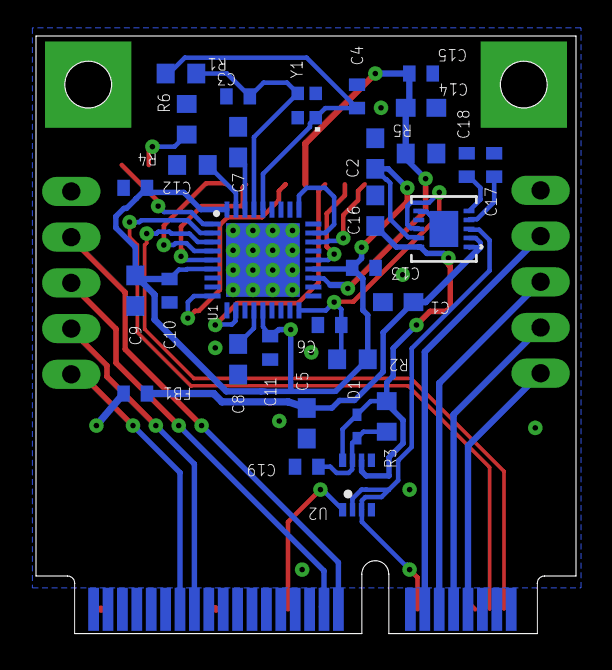
[picture p12: board psvsd-v10.brd from below]

Board: 2 copper layers, 30.0 x 33.2 mm, 36 parts (31 on the bottom side), 35 nets.
