yifanlu/psvsd/breakout/breakout.brd

## EAGLE design breakout/breakout.brd (2017-05-19)

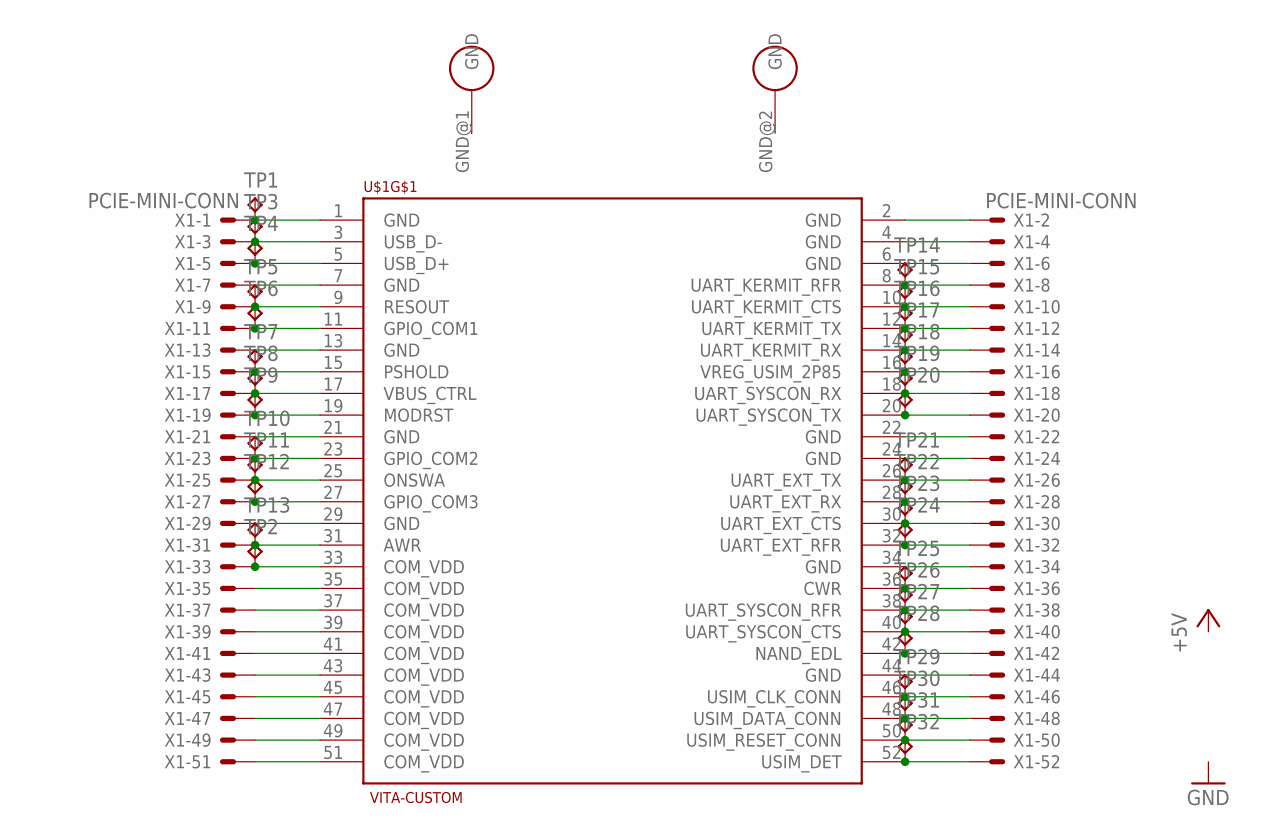
[picture p13: schematic breakout.sch]

Parts:
TP1, TP2, TP3, TP4, TP5, TP6, TP7, TP8, TP9, TP10, TP11, TP12, TP13, TP14, TP15, TP16, TP17, TP18, TP19, TP20, TP21, TP22, TP23, TP24, TP25, TP26, TP27, TP28, TP29, TP30, TP31, TP32: TPTP20R; TP20R
U$1: VITA-CUSTOM; VITA-MINI-PCI-E
X1: PCIE-MINI-CONN

Connections:
+5V: TP2.TP, U$1.33 (COM_VDD), U$1.35 (COM_VDD), U$1.37 (COM_VDD), U$1.39 (COM_VDD), U$1.41 (COM_VDD), U$1.43 (COM_VDD), U$1.45 (COM_VDD), U$1.47 (COM_VDD), U$1.49 (COM_VDD), U$1.51 (COM_VDD), X1.33, X1.35, X1.37, X1.39, X1.41, X1.43, X1.45, X1.47, X1.49, X1.51
AWR: TP13.TP, U$1.31 (AWR), X1.31
CWR: TP25.TP, U$1.36 (CWR), X1.36
GND: TP1.TP, U$1.1 (GND), U$1.2 (GND), U$1.4 (GND), U$1.6 (GND), U$1.7 (GND), U$1.13 (GND), U$1.21 (GND), U$1.22 (GND), U$1.24 (GND), U$1.29 (GND), U$1.34 (GND), U$1.44 (GND), U$1.GND@1 (GND), U$1.GND@2 (GND), X1.1, X1.2, X1.4, X1.6, X1.7, X1.13, X1.21, X1.22, X1.24, X1.29, X1.34, X1.44
GPIO_COM1: TP6.TP, U$1.11 (GPIO_COM1), X1.11
GPIO_COM2: TP10.TP, U$1.23 (GPIO_COM2), X1.23
GPIO_COM3: TP12.TP, U$1.27 (GPIO_COM3), X1.27
MODRST: TP9.TP, U$1.19 (MODRST), X1.19
NAND_EDL: TP28.TP, U$1.42 (NAND_EDL), X1.42
ONSWA: TP11.TP, U$1.25 (ONSWA), X1.25
PSHOLD: TP7.TP, U$1.15 (PSHOLD), X1.15
RESOUT: TP5.TP, U$1.9 (RESOUT), X1.9
UART_EXT_CTS: TP23.TP, U$1.30 (UART_EXT_CTS), X1.30
UART_EXT_RFR: TP24.TP, U$1.32 (UART_EXT_RFR), X1.32
UART_EXT_RX: TP22.TP, U$1.28 (UART_EXT_RX), X1.28
UART_EXT_TX: TP21.TP, U$1.26 (UART_EXT_TX), X1.26
UART_KERMIT_CTS: TP15.TP, U$1.10 (UART_KERMIT_CTS), X1.10
UART_KERMIT_RFR: TP14.TP, U$1.8 (UART_KERMIT_RFR), X1.8
UART_KERMIT_RX: TP17.TP, U$1.14 (UART_KERMIT_RX), X1.14
UART_KERMIT_TX: TP16.TP, U$1.12 (UART_KERMIT_TX), X1.12
UART_SYSCON_CTS: TP27.TP, U$1.40 (UART_SYSCON_CTS), X1.40
UART_SYSCON_RFR: TP26.TP, U$1.38 (UART_SYSCON_RFR), X1.38
UART_SYSCON_RX: TP19.TP, U$1.18 (UART_SYSCON_RX), X1.18
UART_SYSCON_TX: TP20.TP, U$1.20 (UART_SYSCON_TX), X1.20
USB_N: TP3.TP, U$1.3 (USB_D-), X1.3
USB_P: TP4.TP, U$1.5 (USB_D+), X1.5
USIM_CLK_CONN: TP29.TP, U$1.46 (USIM_CLK_CONN), X1.46
USIM_DATA_CONN: TP30.TP, U$1.48 (USIM_DATA_CONN), X1.48
USIM_DET: TP32.TP, U$1.52 (USIM_DET), X1.52
USIM_RESET_CONN: TP31.TP, U$1.50 (USIM_RESET_CONN), X1.50
VBUS_CTRL: TP8.TP, U$1.17 (VBUS_CTRL), X1.17
VREG_USIM_2P85: TP18.TP, U$1.16 (VREG_USIM_2P85), X1.16

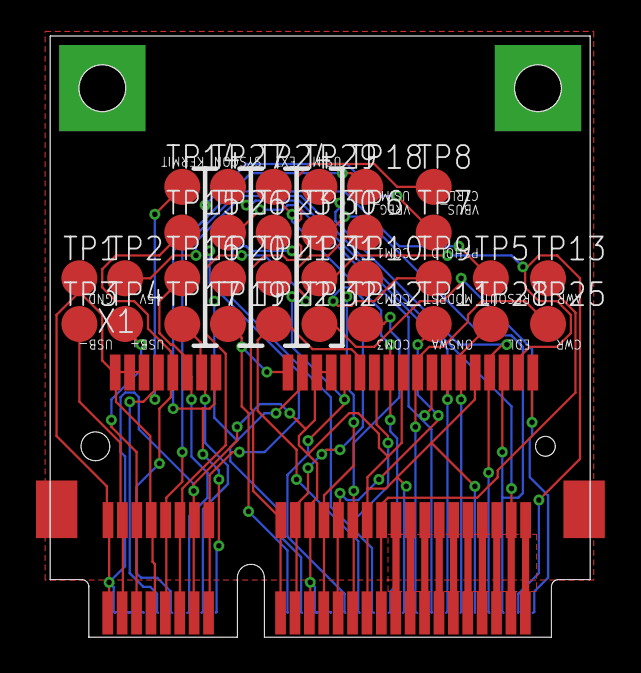
[picture p14: board breakout.brd from above]

Board: 2 copper layers, 30.0 x 33.4 mm, 34 parts (0 on the bottom side), 32 nets.
