yifanlu/psvsd/(commit log)

2017-04-21 Initial commit.
    [psvsd-v10.brd, psvsd-v10.sch]
2017-04-25 DRC fixes
    [psvsd-v10.brd, psvsd-v10.sch]
2017-04-25 More cleanups
    [psvsd-v10.brd, psvsd-v10.sch]
2017-04-25 Fixed dimensions
    [psvsd-v10.brd]
2017-04-25 Name/value layout in bottom layer
    [psvsd-v10.brd]
2017-04-25 Added forgotten tStop layer to USB2244 chip
    [psvsd-v10.brd, psvsd-v10.sch]
2017-04-25 Moved some labels away from vias
    [psvsd-v10.brd]
2017-04-25 Added BOM
    [bom.csv]
2017-04-26 Added breakout board
    [breakout.brd, breakout.sch]
2017-04-26 Removed molex mark from silkscreen
    [breakout.brd, breakout.sch]
2017-04-26 Better routing of the +5V pins to handle large currents
    [breakout.brd]
2017-04-26 Fix incorrect signal in breakout board
    [breakout.brd, breakout.sch]
2017-04-26 Fixed USB+/USB- signal in psvsd
    [psvsd-v10.brd, psvsd-v10.sch]
2017-04-26 Fixed DRC for new USB lines placement
    [psvsd-v10.brd]
2017-04-27 Added new hinge-type microsd connector
2017-05-18 Added LED indicator
    [bom.csv, psvsd-v10.brd, psvsd-v10.sch]
2017-05-19 Updated board to be right size
    [breakout.brd, breakout.sch, psvsd-v10.brd, psvsd-v10.sch]
2017-05-19 Resize both boards
    [breakout.brd, breakout.sch, psvsd-v10.brd, psvsd-v10.sch]
2017-05-19 Shifted all components up in the new space
    [psvsd-v10.brd]
2017-05-19 Extended ground plane on top layer to even electric properties
    [psvsd-v10.brd]
2017-05-20 Replaced microSD connector with cheaper part
    [bom.csv]
2017-05-20 Added value for LED
    [psvsd-v10.brd, psvsd-v10.sch]
2017-05-20 Removed unneedeed lbr for hinge type molex connector
2017-05-24 Moved some labels in the silkscreen to prevent being cut off
    [psvsd-v10.brd]
2017-05-26 Moved two GND pin routing out of the flag since it is discouraged
    [psvsd-v10.brd]
2017-05-26 Enhanced heat sink under chip
    [psvsd-v10.brd]
2017-05-26 Added a power plane on top to dissipate the many +5V inputs
    [psvsd-v10.brd]
2017-05-27 Added MEM2051 part that will be used
    [psvsd-v10.brd, psvsd-v10.sch]
2017-05-27 Reconnected ground planes
    [psvsd-v10.brd]
2017-05-27 Wrong silkscreen layer
    [psvsd-v10.brd]
2017-05-27 Changed RC circuit for reset to be tolerant of 4.0V
    [bom.csv, psvsd-v10.brd, psvsd-v10.sch]
2017-06-01 Updated dimension size, off by 0.2mm
    [psvsd-v10.brd, psvsd-v10.sch]
2017-06-11 Moved some labels around in silkscreen
    [psvsd-v10.brd]
2017-06-18 Removed drill through pad because excess solder shorting sd socket pins
    [psvsd-v10.brd]
2017-06-22 Removed old LDO and reset circuit. Added new power efficient POR circuit & dual channel LDO
    [psvsd-v10.brd, psvsd-v10.sch]
2017-06-22 Layout for PM circuit
    [psvsd-v10.brd, psvsd-v10.sch]
2017-06-22 Changed to cheaper molex slot
    [psvsd-v10.brd, psvsd-v10.sch]
2017-06-22 Routed new layout
    [psvsd-v10.brd]
2017-06-22 Placed labels for new components
    [psvsd-v10.brd, psvsd-v10.sch]
2017-06-22 Forgot to rotate a label
    [psvsd-v10.brd]
2017-06-22 Changed crystal
    [psvsd-v10.brd, psvsd-v10.sch]
2017-06-22 Updated BOM finishing new design. Resolves #2
    [bom.csv, psvsd-v10.brd]
2017-06-25 Added v2.0 design
    [psvsd-v20.brd, psvsd-v20.sch]
2017-06-26 Placed labels in new design
    [psvsd-v20.brd, psvsd-v20.sch]
2017-06-26 Added molecule logo to new design
    [psvsd-v20.brd]
2017-06-26 Added BOM for v2 design
    [bom_v2.csv]
2017-06-26 Added USB trace clearance recommendations from GL823 design docs
    [psvsd-v20.brd, psvsd-v20.sch]
2017-07-08 Changed bypass value for DVDD2 and added a new ferrite bead to AVDD
    [psvsd-v20.brd, psvsd-v20.sch]
2017-07-11 Added RC delay to power circuit
    [psvsd-v20.brd, psvsd-v20.sch]
2017-07-11 Added v2.1 design without power circuit
    [psvsd-v21.brd, psvsd-v21.sch]
2017-07-12 Finished silkscreen and added BOM for v2.1 design
    [bom_v21.csv, psvsd-v21.brd, psvsd-v21.sch]
2017-08-17 Fixed problem where shield is not grounded
    [psvsd-v21.brd, psvsd-v21.sch]
2018-03-02 Added psvemmc
    [psvemmc-v10.brd, psvemmc-v10.sch]
2018-03-08 Added BOM for psvemmc
    [bom_psvemmc_v1.csv]
2018-03-15 psvemmc v1.1: fixed missing caps for crystal and fixed direction of translator
    [bom_psvemmc_v1.csv, psvemmc-v10.brd, psvemmc-v10.sch]
2018-04-02 psvemmc v1.2: changed broken TTL translater
    [bom_psvemmc_v12.csv, psvemmc-v12.brd, psvemmc-v12.sch]
2018-04-02 psvemmc v1.2: unified drill sizes, added thermal vias to TTL translation IC
    [psvemmc-v12.brd, psvemmc-v12.sch]
2018-07-09 Added psvemmc v2.0
    [bom_psvemmc_v12.csv, psvemmc-v10.brd, psvemmc-v10.sch, psvemmc-v12.brd, psvemmc-v12.sch, psvemmc-v20.brd, psvemmc-v20.sch]
2018-07-14 psvemmc v2.1: added EEPROM and GND pad
    [psvemmc-v20.brd, psvemmc-v20.sch]
2018-07-27 psvemmc: v3.0 design with USB protection and clock buffering
    [bom_psvemmc_v12.csv, bom_psvemmc_v30.csv, psvemmc-v30.brd, psvemmc-v30.sch]
2018-07-27 psvsd: moved bom to psvsd directory
    [bom.csv, bom_v2.csv, bom_v21.csv]
2018-08-10 Tent vias for psvemmc
    [psvemmc-v30.brd]
2018-08-12 psvemmc v3.1: fixed wrong pin ordering on clk buffer added pin 1 indicator to components missing them added title/value for sch in buffer components
    [psvemmc-v30.brd, psvemmc-v30.sch]
2018-08-19 psvemmc: Wrong part number in BOM (doh)
    [bom_psvemmc_v30.csv]
